joshuaglenen/Greenhouse-Monitor/prototype_2/PCB.PNG

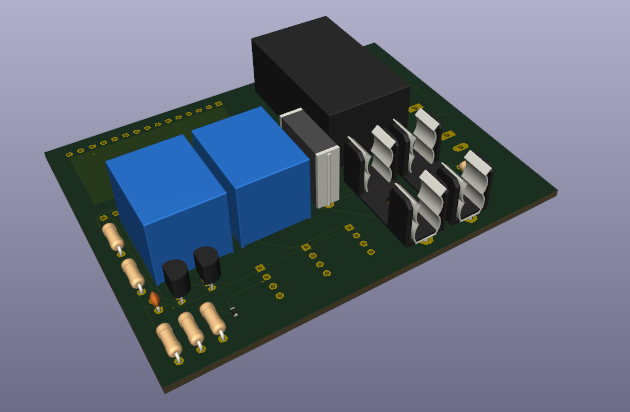
prototype_2/PCB.PNG
