joshuaglenen/Greenhouse-Monitor/prototype_2/Prototype_2_Circuit_Diagram.png

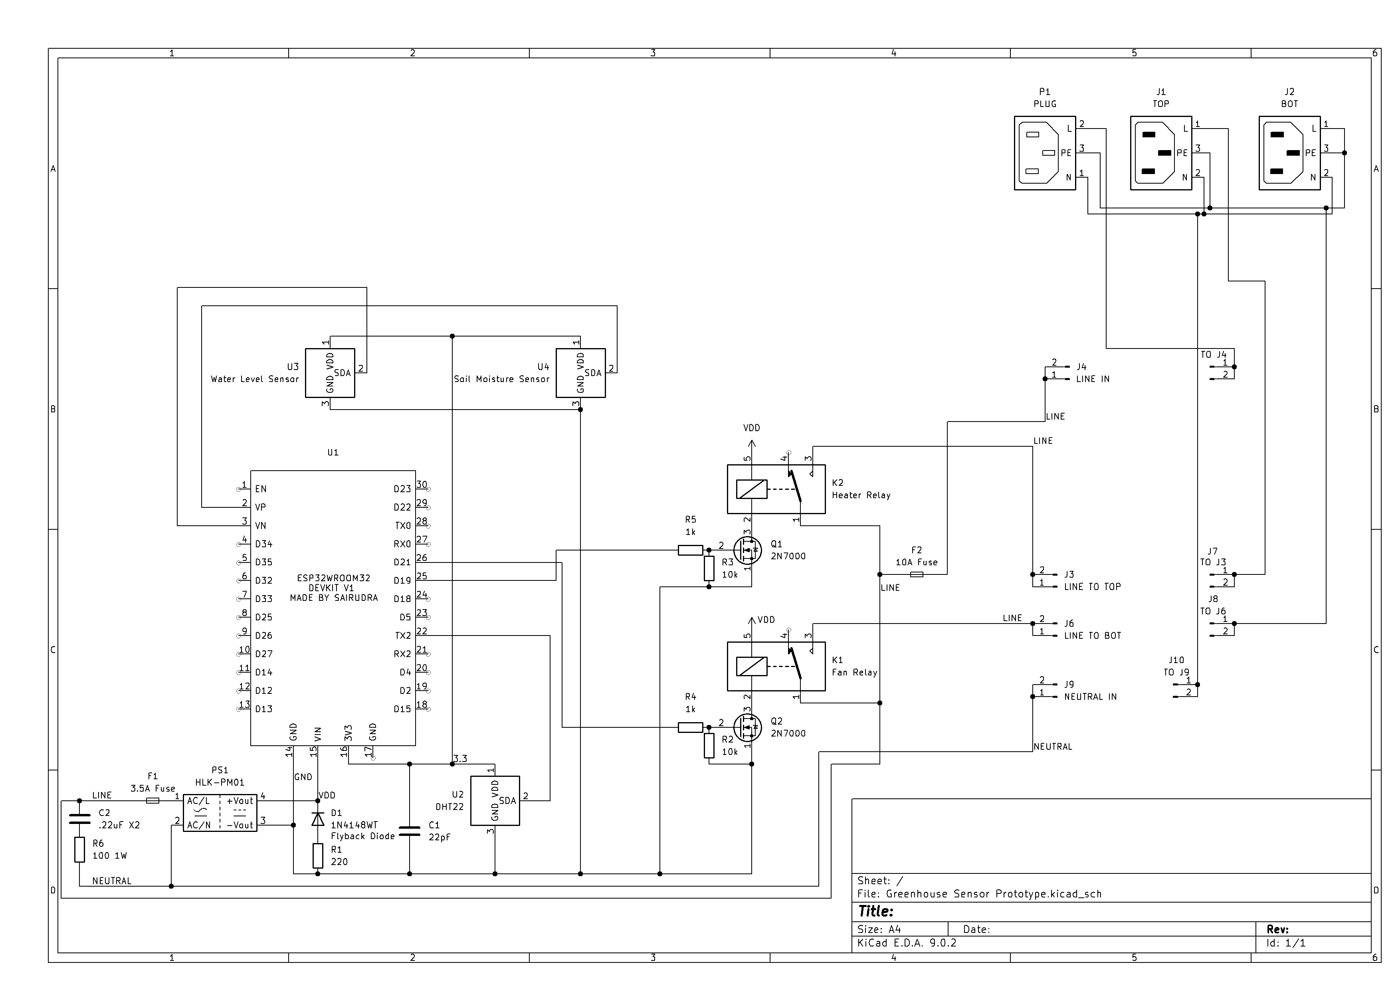
prototype_2/Prototype_2_Circuit_Diagram.png
