joshuaglenen/Greenhouse-Monitor/prototype_2/main.cpp

#include <DHT.h>
#include <Preferences.h>
#include <WiFi.h>
#include <WebServer.h>
#include <WiFiManager.h>
#include <FS.h>
#include <HTTPClient.h>
#include <ArduinoOTA.h>
#include <ArduinoJson.h>

// === Pin Assignments ===
#define DHTPIN 17
#define DHTTYPE DHT22
#define FAN_PIN 21
#define HEATER_PIN 19
#define WATER_PIN 39
#define SOIL_PIN 36  
const String webappURL = "https://greenhouse-monitor.onrender.com/"; //"http://192.168.2.224:5000"; //

// === Constraints ===
int tempMin = 10;
int tempMax = 40;
int SOIL_MIN = 30;
int WATER_MIN = 0;

// === Global Variables ===
Preferences preferences;
WebServer server(80);
WiFiManager wifiManager;
unsigned long lastUpdate;
bool heaterOverride = false;
bool soilSensors = false;
bool fanOverride = false;
DHT dht(DHTPIN, DHTTYPE);

// Example sensor readings
float temp = 20;
float hum = 50;
int water = 50;
int soil = 50;

// === Request Handlers ===

void handleSetConstraints() {
  if (server.hasArg("min")) {
    tempMin = server.arg("min").toInt();
  }
  if (server.hasArg("max")) {
    tempMax = server.arg("max").toInt();
  }
  // dont let the user submit unrealistic values
  if(tempMin<0) tempMin = 0; 
  if(tempMax>50) tempMax = 50; 
  if(tempMin>tempMax) tempMin = tempMax -1; 
  
  preferences.begin("settings", false); // read+write
  preferences.putInt("tempMin", tempMin);
  preferences.putInt("tempMax", tempMax);
  preferences.end();

  String response = "Updated constraints:\n";
  response += "Min Temp = " + String(tempMin) + "\n";
  response += "Max Temp = " + String(tempMax);
  server.send(200, "text/plain", response);
}

void handleToggleFan() {
  fanOverride = !fanOverride;
  digitalWrite(FAN_PIN, fanOverride ? HIGH : LOW);
  server.send(200, "text/plain", fanOverride ? "ON" : "OFF");
}

void handleToggleHeater() {
  heaterOverride = !heaterOverride;
  digitalWrite(HEATER_PIN, heaterOverride ? HIGH : LOW);
  server.send(200, "text/plain", heaterOverride ? "ON" : "OFF");
}

void handleToggleSoil() {
  soilSensors = !soilSensors;
  server.send(200, "text/plain", soilSensors ? "ON" : "OFF");
}


void handlemacAddr() {
  String mac = WiFi.macAddress();
  server.send(200, "text/plain", mac);
}


void handleData() {
  //read data
  updateSensorReadings();
  
  // Create JSON response manually
  String json = "{";
  json += "\"temp\":" + String(temp, 1) + ",";
  json += "\"hum\":" + String(hum, 1) + ",";
  json += "\"water\":" + String(water) + ",";
  json += "\"soil\":" + String(soil);
  json += "}";

  server.send(200, "application/json", json);
  Serial.println(json);
}

// === Climate Control (Auto Mode Only) ===
void controlClimateAuto() {
  if (temp > tempMax) {
    Serial.println("Activating FAN!");
    digitalWrite(FAN_PIN, HIGH);
    digitalWrite(HEATER_PIN, LOW);
  } else if (temp < tempMin) {
    Serial.println("Activating HEATER!");
    digitalWrite(FAN_PIN, LOW);
    digitalWrite(HEATER_PIN, HIGH);
  } else {
    digitalWrite(FAN_PIN, LOW);
    digitalWrite(HEATER_PIN, LOW);
  }
}

void checkMoisture() {
  if (water < WATER_MIN || soil < SOIL_MIN) {
    Serial.println("Warning: Low soil moisture or water level!");
  }
}

// == uses analog read to redefine global variables
void updateSensorReadings()
{
  float t = dht.readTemperature();
  float h = dht.readHumidity();

  //dht22 has instability over many cycles so it needs to reboot ocasionally
  if (isnan(t) || isnan(h)) {
    waitForValidSensorReadings();
    t = dht.readTemperature();
    h = dht.readHumidity();
  }

  else {
    temp = t;
    hum = h;
  }
  
  if(soilSensors)
  {
  water = analogRead(WATER_PIN);
  soil = analogRead(SOIL_PIN);
  //water = map(water, 0, 805, 0, 42.31); //0 to 4cm
  //soilPercent = map(soil, 4095, 530, 0, 100); // up to 100%
  }
}

void sendServerData() {
  updateSensorReadings();

  //ping ThingSpeak
  HTTPClient http;
  String url = "http://api.thingspeak.com/update?api_key=TK9X4Z5W6RQHZ70P";
  url += "&field1=" + String(temp, 1);
  url += "&field2=" + String(hum, 1);
  url += "&field4=" + String(water);
  url += "&field5=" + String(soil);

  http.begin(url);
  int httpCode = http.GET();
  Serial.printf("ThingSpeak response: %d\n", httpCode);
  http.end();
}

void sendSensorData() {
  updateSensorReadings();

  if (!fanOverride && !heaterOverride)
    controlClimateAuto();
  if (soilSensors)
    checkMoisture();

  HTTPClient http;

  http.begin(webappURL + "/submit-data");
  http.addHeader("Content-Type", "application/json");

  String json = "{\"mac\":\"" + WiFi.macAddress() + 
              "\",\"temp\":" + String(temp, 1) +
              ",\"hum\":" + String(hum, 1) +
              ",\"water\":" + String(water) +
              ",\"soil\":" + String(soil) + "}";

  int httpResponseCode = http.POST(json);

  if (httpResponseCode == 200) {
  String response = http.getString();
  Serial.println("Command response:");
  Serial.println(response);

    DynamicJsonDocument doc(256);
    DeserializationError error = deserializeJson(doc, response);
    if (!error) {
      if (doc["toggle_fan"]) {
        handleToggleFan();
      }
      if (doc["toggle_heater"]) {
        handleToggleHeater();
      }
      if (doc["toggle_soil"]) {
        handleToggleSoil();
      }

      if (doc["update_constraints"]) {
        int minT = doc["update_constraints"]["min_temp"];
        int maxT = doc["update_constraints"]["max_temp"];
        if (minT > 0 && maxT > 0) {
          
          // dont let the user submit unrealistic values
          if(minT!=tempMin && maxT!=tempMax)
          {
            if(minT<0) minT = 0; 
            if(maxT>50) maxT = 50; 
            if(minT>maxT) minT = maxT -1; 
            tempMin = minT;
            tempMax = maxT;
            preferences.begin("settings", false); // read+write
            preferences.putInt("tempMin", tempMin);
            preferences.putInt("tempMax", tempMax);
            preferences.end();
          }
        }
      }
    }
  }


  http.end();
}

//case when t&h are NaN, wait until !NaN then set t&h, otherwise skip readings
void waitForValidSensorReadings() {
  static bool stopReadingSensorData = false;
  if(stopReadingSensorData) return;

  preferences.begin("settings", false);
  bool alreadyRebooted = preferences.getBool("alreadyRebooted", false);
  preferences.end();


  //get a valid sensor reading. Note: can take up to 30 seconds
  for (int i = 0; i < 10; i++) {
    float t = dht.readTemperature();
    float h = dht.readHumidity();
    if (!isnan(t) && !isnan(h)) {
      temp = t;
      hum = h;

      //reboot successfully reengaged sensor
      if(alreadyRebooted)
      {
        preferences.begin("settings", false);
        preferences.putBool("alreadyRebooted", false);
        preferences.end();
      }
      return;
    }
    delay(2000);
  }
  
  //DHT22 did not recover on reboot, TODO: toggle the power to the sensor with a 2N7000
  if(alreadyRebooted)
  {
    temp = 22.22;
    hum = 55.55;
    stopReadingSensorData = true;
    return;
  }

  //attempt a reboot
  preferences.begin("settings", false);
  preferences.putBool("alreadyRebooted", true);
  preferences.end();
  ESP.restart();
}



void setup() {
  //debugging
  Serial.begin(115200);

  //settings are loaded and read
  preferences.begin("settings", true); // read-only
  tempMin = preferences.getInt("tempMin", 10); // 10 is the default
  tempMax = preferences.getInt("tempMax", 40);
  preferences.end();

  //connect to wifi
  wifiManager.autoConnect("Greenhouse-Monitor");
  Serial.print("Connected to Wi-Fi IP: ");
  Serial.println(WiFi.localIP());
  ArduinoOTA.setHostname("Greenhouse-Monitor");
  ArduinoOTA.begin();


  //set GPIO
  dht.begin();
  pinMode(FAN_PIN, OUTPUT);
  pinMode(HEATER_PIN, OUTPUT);
  delay(2000);
  waitForValidSensorReadings();
  
  //define routes
  server.on("/toggleFan", handleToggleFan);
  server.on("/toggleHeater", handleToggleHeater);
  server.on("/toggleSoil", handleToggleSoil);
  server.on("/data", handleData);
  server.on("/mac-addr", handlemacAddr);
  server.on("/set-constraints", handleSetConstraints);
  server.begin();
  delay(3000);
  Serial.println("Web server started.");
}

void loop() {
  server.handleClient();
  ArduinoOTA.handle();

  static unsigned long lastServerSend = 0;
  static unsigned long lastSensorSend = 0;
  if (millis() - lastServerSend > 30000) {
    lastServerSend = millis();
    sendServerData();
  }
  if (millis() - lastSensorSend > 5000) {
    lastSensorSend = millis();
    sendSensorData();
  }
}
